giacomoradin/SmartVase/docs/SmartVase_data_structure.md

# SmartVase Data Structure and Architecture

This document outlines the communication pathways, MQTT topics, and Firestore paths used in the SmartVase system. 

### Architectural Overview
The system employs a hybrid communication model to optimize for hardware capabilities:
1. **ESP32-HUB (Telemetry & Control):** Communicates exclusively via lightweight MQTT. An Oracle Linux server running `mqtt_firestore_bridge.py` acts as a secure bi-directional bridge, translating MQTT payloads to/from Cloud Firestore.
2. **ESP32-CAM (Vision & Storage):** Communicates with Firebase Storage and Firestore, bypassing MQTT entirely.
3. **Flutter App:** Communicates exclusively with Firebase (real-time listeners for UI updates via Firestore, and loading images from Firebase Storage)

---

## 1. Telemetry Data

**Purpose:** Periodic sensor readings and device status sent from the ESP32 Hub.
**Direction:** ESP32 Hub -> MQTT Broker -> Oracle Server (`mqtt_firestore_bridge.py`) -> Firestore -> Flutter App
**MQTT Topic:** `smartvase/{hub_id}/telemetry`
**Firestore Path:** `smartvase/{hub_id}/telemetry/telemetry` *(Document ID: telemetry)*

**JSON Payload Example** (Hub v1.4.0 / proto v4.2; ambient fields such as
`temperature_c`, `humidity_percent`, `pressure_hpa` and `battery_voltage` are
included only when the corresponding sensor is fitted and returns a valid
reading; `time_valid` is false while the Mega runs on an unsynchronized software fallback
clock (RTC absent and no NTP sync received yet), meaning `timestamp_utc` defaults to
1970-01-01 08:00 and must not be used to date historical data):
{
  "timestamp_utc": 1678886400,
  "time_valid": true,
  "uptime_s": 12345,
  "device_id": "HUB_123456",
  "fw_version": "1.4.0",
  "movement_state": "IDLE",
  "lux": 540,
  "soil_moisture": 550,
  "water_level_cm": 14.5,
  "distances_cm": { "top": 87.2, "front_right": 120.5, "front_left": 95.1, "left": 44.0, "right": 61.3 },
  "free_ram_bytes": 2729,
  "counters": {
    "watchdog_resets": 0,
    "total_irrigations": 12,
    "total_irrigation_duration_s": 48,
    "total_motor_active_time_s": 310,
    "obstacles_avoided": 7,
    "stuck_events": 0,
    "bme_read_errors": 0,
    "log_overflows": 0,
    "pb_decode_failures": 0,
    "light_seeking_sessions": 5,
    "shadow_seeking_sessions": 2,
    "escape_attempts": 1
  },
  "care": {
    "enabled": true,
    "state": "BASK",
    "light_budget_pct": 62,
    "relocations_today": 2,
    "water_doses_today": 1,
    "growlight_min_today": 0
  }
}

The `care` object (proto v4.2, Mega v5.4.0+) carries the daily KPIs of the
autonomous care layer: `state` is one of `NIGHT | SEEK_SUN | BASK |
SEEK_SHADE | SHELTER | TOP_UP`, `light_budget_pct` is the percentage of the
plant profile's daily light target achieved so far (may exceed 100), and the
remaining fields are today's actuation counters. `enabled: false` means the
care layer is off and the values are static zeros.

### 1.1 LWT Status and Command Acknowledgment

**Purpose:** Connection status (Last Will and Testament) and command execution feedback.
**Direction:** ESP32 Hub -> MQTT Broker -> Oracle Server -> Firestore -> Flutter App
- **Status Topic:** `smartvase/{hub_id}/status` (retained `online` or `offline`)
- **Ack Topic:** `smartvase/{hub_id}/command/ack` (returns `status`, `value`, `cmd_id`, and `exec_time_ms`)

## 2. Log Events

**Purpose:** Event logs generated by the ESP32 Hub (e.g., errors, warnings, info).
**Direction:** ESP32 Hub -> MQTT Broker -> Oracle Server (`mqtt_firestore_bridge.py`) -> Firestore -> Flutter App
**MQTT Topic:** `smartvase/{hub_id}/logs`
**Firestore Path:** `smartvase/{hub_id}/logs/{auto_generated_id}` *(Collection: logs)*

**JSON Payload Example:**
{
  "timestamp_utc": 1678886500,
  "level": "ERROR", 
  "event": "WATER_LEVEL_LOW",
  "detail": "Water level below 5cm"
}

### 2.1 Autonomous-care events (Mega v5.4.0)

With the autonomous care layer enabled (`care on`, see
`docs/Plant_Care_Design.md`), the Mega emits the following events through the
normal log pipeline (same topic/path as above). They complement the `care`
object of the telemetry (§1): the telemetry carries the current KPI snapshot,
these logs carry the discrete events and the end-of-day summary:

| `event` | `level` | `detail` | Meaning |
|---|---|---|---|
| `care_day_end` | INFO | `b<pct> d<n> r<n> g<min>` | Daily KPI summary at day rollover: light-budget % achieved, water doses, relocations, UVA top-up minutes. Example: `b82 d2 r3 g15` |
| `care_state` | INFO | `SEEK_SUN` / `BASK` / `SEEK_SHADE` / `SHELTER` / `TOP_UP` / `NIGHT` | Care state transition |
| `care_water` | INFO | `dose` / `cycle_done` | One irrigation dose delivered / dose-soak-verify cycle completed (wet target reached) |
| `care_water` | WARN | `tank_empty` / `dose_cap` | Dose skipped: empty tank (refill needed) / daily dose cap hit (possible soil-probe fault) |
| `care_paused` | INFO | `manual_override` | A manual `setMode` (app/CLI) suspended autonomy for 30 minutes |
| `care_resumed` | INFO | `override_expired` | Autonomy resumed after the override grace period |

The app can parse `care_day_end` to render the daily "plant wellness"
summary (budget ring + doses + relocations) without any schema change.

## 3. Configuration Command

**Purpose:** Settings sent from the Flutter App to configure the ESP32 Hub's behavior (sensor thresholds). 
**Direction:** Flutter App -> Firestore -> Oracle Server (`mqtt_firestore_bridge.py` Listener) -> MQTT Broker -> ESP32 Hub
**Firestore Path:** `smartvase/{hub_id}/command/config`
**MQTT Topic:** `smartvase/{hub_id}/command/config`

**JSON Payload Example:**
{
  "soil_dry_threshold": 450,
  "light_threshold": 400
}

## 4 Action Commands

**Purpose:** Commands sent from the Flutter App to trigger specific physical actions or request diagnostics on the SmartVase.
**Direction:** Flutter App -> Firestore -> Oracle Server (`mqtt_firestore_bridge.py` Listener) -> MQTT Broker -> ESP32 Hub -> Arduino Mega
**Firestore Path:** `smartvase/{hub_id}/command/{action}`
**MQTT Topic:** `smartvase/{hub_id}/command/{action}`

Supported actions:
- **Water (Start Irrigation):**
  - Path: `smartvase/{hub_id}/command/water`
  - JSON: `{"cmd_id": 101, "type": "water", "duration_ms": 5000}`
- **Set Mode:**
  - Path: `smartvase/{hub_id}/command/setMode`
  - JSON: `{"cmd_id": 102, "type": "setMode", "mode": "LIGHT"}` *(mode can be "LIGHT", "SHADOW", or "IDLE")*
- **Emergency Stop:**
  - Path: `smartvase/{hub_id}/command/stop`
  - JSON: `{"cmd_id": 103, "type": "stop"}`
- **Request Diagnostics:**
  - Path: `smartvase/{hub_id}/command/requestDiagnostics`
  - JSON: `{"cmd_id": 104, "type": "requestDiagnostics"}`
- **Set Motion/Turn Parameters:**
  - Path: `smartvase/{hub_id}/command/setMotionParams`
  - JSON: `{"cmd_id": 105, "type": "setMotionParams", "reverse_ms": 1000, "turn_ms": 1200}`
- **Read Soil Humidity:**
  - Path: `smartvase/{hub_id}/command/readSoil`
  - JSON: `{"cmd_id": 106, "type": "readSoil"}`
- **Soft Reset Arduino Mega:**
  - Path: `smartvase/{hub_id}/command/softReset`
  - JSON: `{"cmd_id": 107, "type": "softReset"}`

## 5. Image Ready Notification (Edge Computed)

**Purpose:** This gets updated when a new image has been uploaded to Firebase Cloud Storage AND the leaf health analysis has been completed (by the lightweight vision algorithm on the edge).
**Direction:** ESP32-CAM -> Firebase (Storage & Firestore) -> Flutter App
*Note: This data path bypasses MQTT entirely.*
**Firestore Path:** `smartvase/{cam_id}/vision/latest`

**JSON Payload Example:**
{
  "timestamp_utc": 1678886405,
  "image_url": "gs://smartvase-7cfd9.firebasestorage.app/images/CAM_123456_1678886405.jpg",
  "resolution": "800x600",
  "size_bytes": 397847,
  "crc32": 1239082,
  "capture_time_ms": 254,
  "plant_healthy": true,
  "status_message": "Healthy: Basil plant has good turgor and green foliage!",
  "foliage_coverage": "45.2%",
  "green_ratio": "85.1%",
  "brown_ratio": "4.3%"
}

## Notes
For the device ids are hardcoded:
- hub_id = HUB_123456
- cam_id = CAM_123456
