giacomoradin/SmartVase/docs/assets/SmartVaseProjectPresentation.pdf

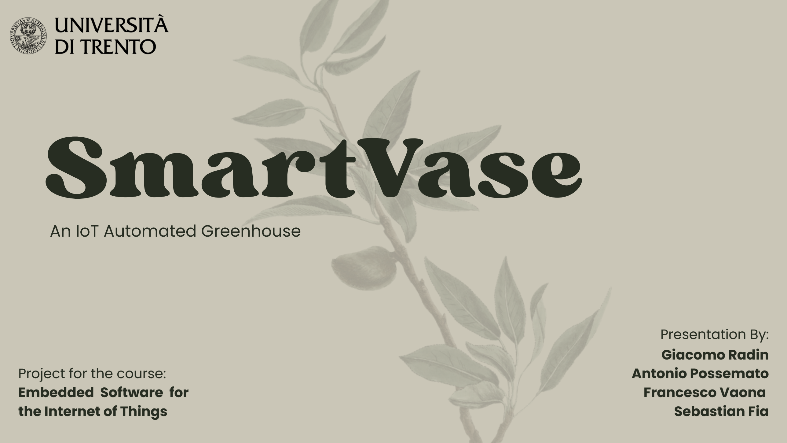
[picture p3: page 1]

# SmartVase

Presentation By:
Giacomo Radin
Antonio Possemato
Francesco Vaona
Sebastian Fia

Project for the course:
Embedded Software for
the Internet of Things

## An IoT Automated Greenhouse

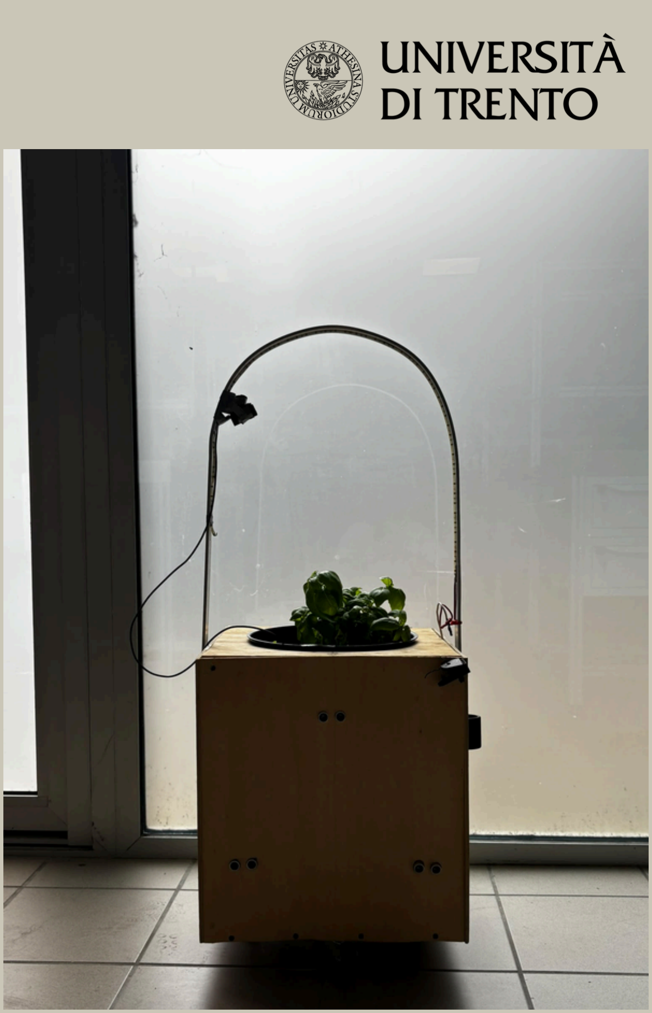
[picture p4: figure]

# Project Outline

A plant in a normal vase cannot survive without continuous human care. To solve this we created Smartvase: an IoT vase that makes plants grow reliably and autonomously.

Features:
Light detection, movement towards light, UV lighting Ultrasensors for Movement
Humidity detection, automatic irrigation
Periodic image capture and leaf health analysis on edge Mobile app to monitor and control the system

Main Hardware components
Arduino Mega: direct hardware control of sensors and actuators ESP32 Standard(HUB): communication hub of the system ESP32-CAM: image capture and edge analysis

Project members contributions
We mainly worked togther in the fablab from the same pc At the end we divided the sections to finish the project

# Internal Communication and

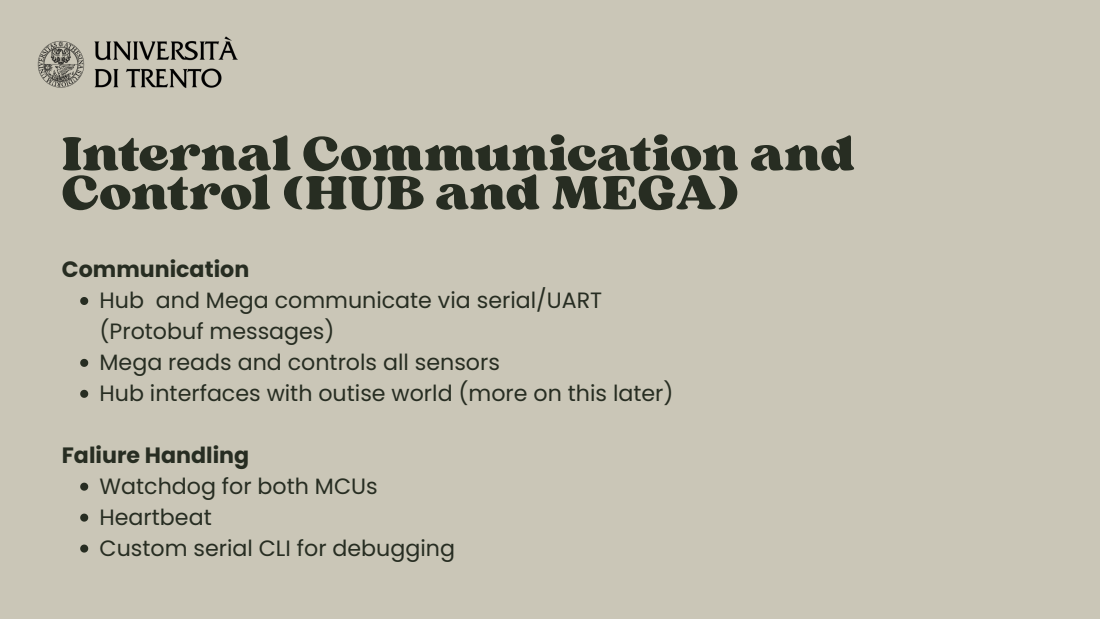
[picture p5: page 3]

Control (HUB and MEGA)

Communication
Hub and Mega communicate via serial/UART
(Protobuf messages)
Mega reads and controls all sensors
Hub interfaces with outise world (more on this later)

Faliure Handling
Watchdog for both MCUs
Heartbeat
Custom serial CLI for debugging

# Core Algorithms and Logic

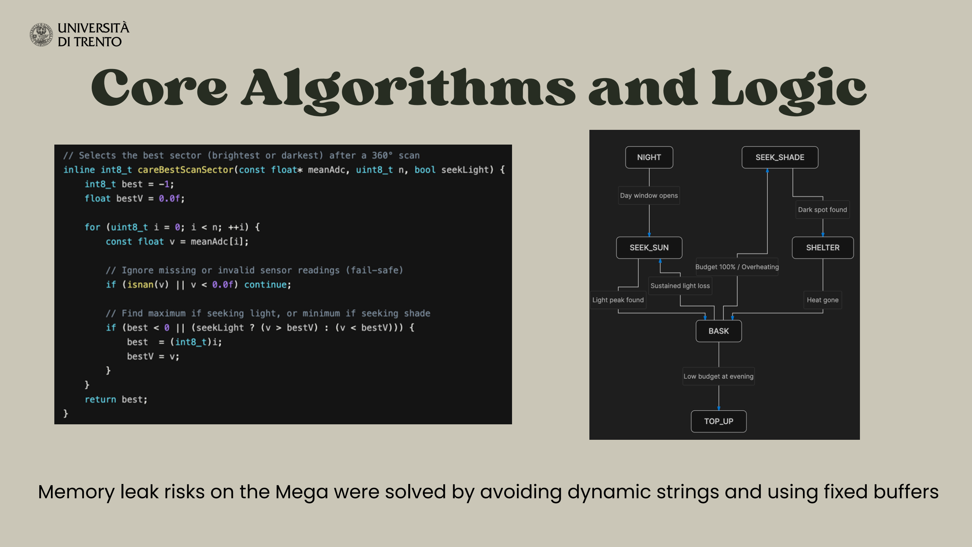
[picture p6: page 4]

Memory leak risks on the Mega were solved by avoiding dynamic strings and using fixed buffers

# External Communication

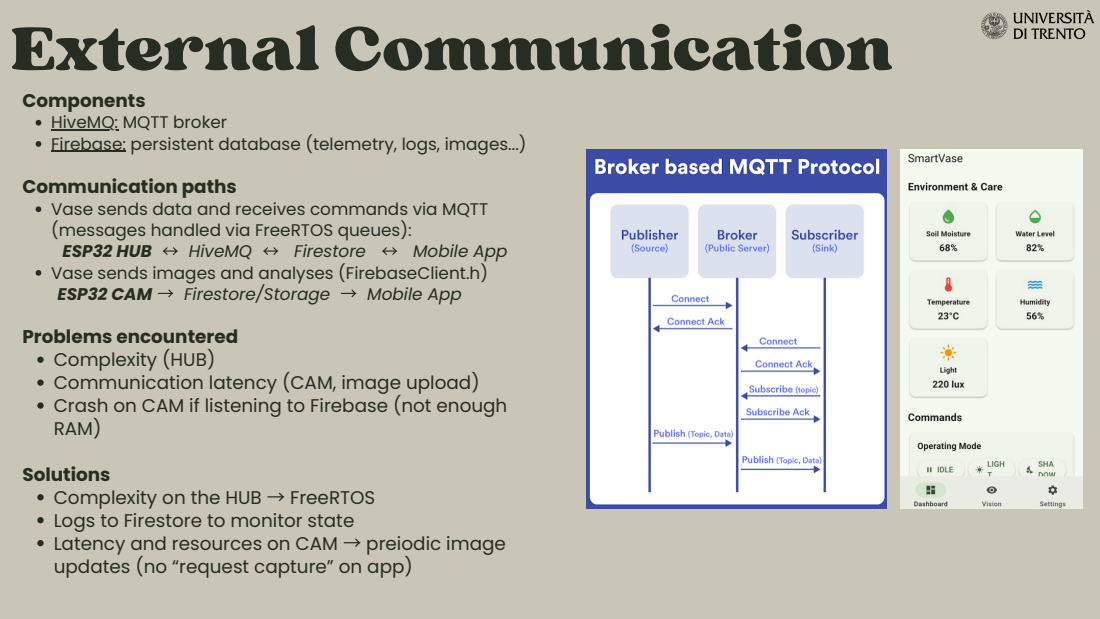
[picture p7: page 5]
ESP32 HUB ↔; HiveMQ ↔; Firestore ↔; Mobile App; ESP32 CAM →; Firestore/Storage →

Components
HiveMQ: MQTT broker
Firebase: persistent database (telemetry, logs, images...)
Communication paths
Vase sends data and receives commands via MQTT
(messages handled via FreeRTOS queues):
Vase sends images and analyses (FirebaseClient.h)
Problems encountered
Complexity (HUB)
Communication latency (CAM, image upload)
Crash on CAM if listening to Firebase (not enough
RAM)
Solutions
Complexity on the HUB → FreeRTOS
Logs to Firestore to monitor state
Latency and resources on CAM → preiodic image
updates (no “request capture” on app)

### On-Device Edge Vision: Configures the OV2640 sensor via I2C (SCCB)

# On-Edge Vision & Diagnostics

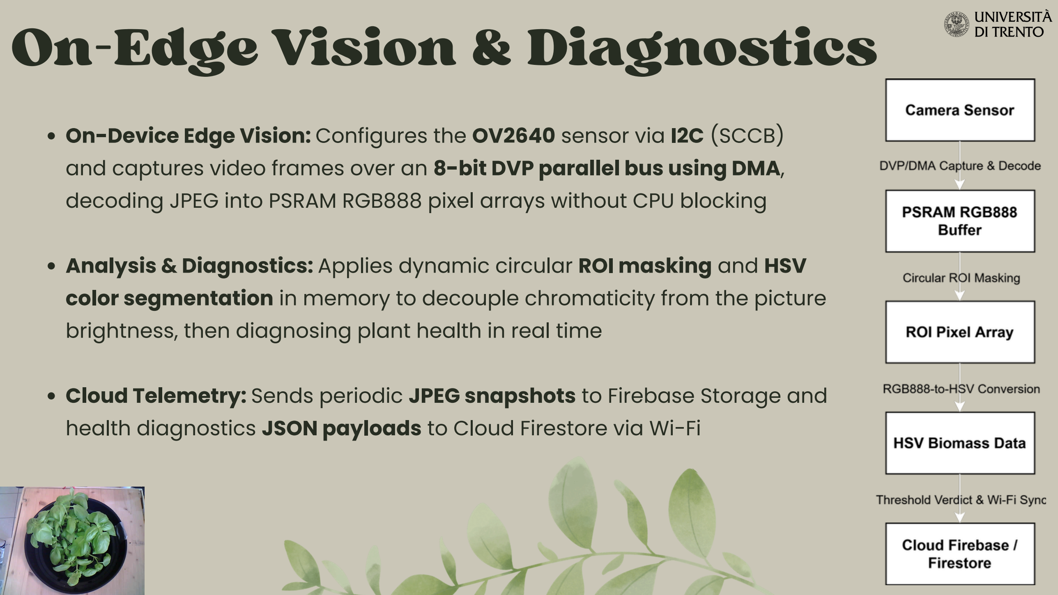
[picture p8: page 6]

and captures video frames over an 8-bit DVP parallel bus using DMA,

### decoding JPEG into PSRAM RGB888 pixel arrays without CPU blocking

### Analysis & Diagnostics: Applies dynamic circular ROI masking and HSV color segmentation in memory to decouple chromaticity from the picture brightness, then diagnosing plant health in real time

### Cloud Telemetry: Sends periodic JPEG snapshots to Firebase Storage and health diagnostics JSON payloads to Cloud Firestore via Wi-Fi

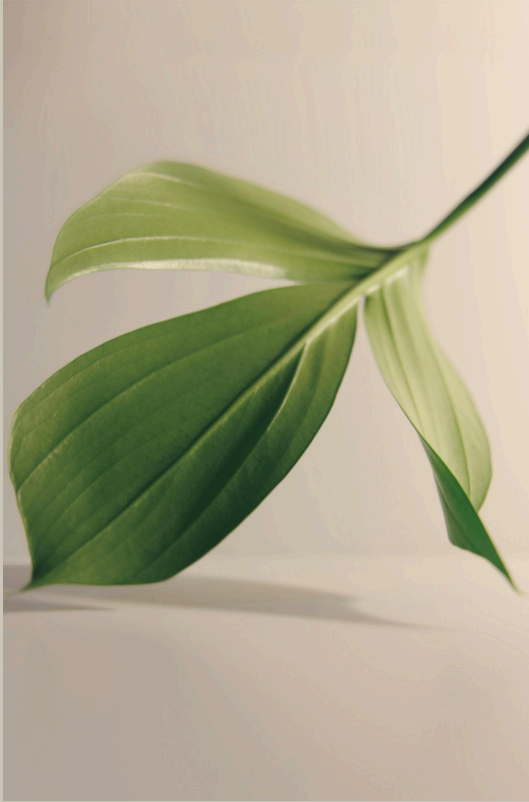
[picture p9: figure]

# Future Work

## ML system for vision, create labeled dataset taking pictures with CAM Request image capture on CAM via MQTT Additional app features (e.g. control movement directly, images timelapse) Docking Station for battery recharge and water refill

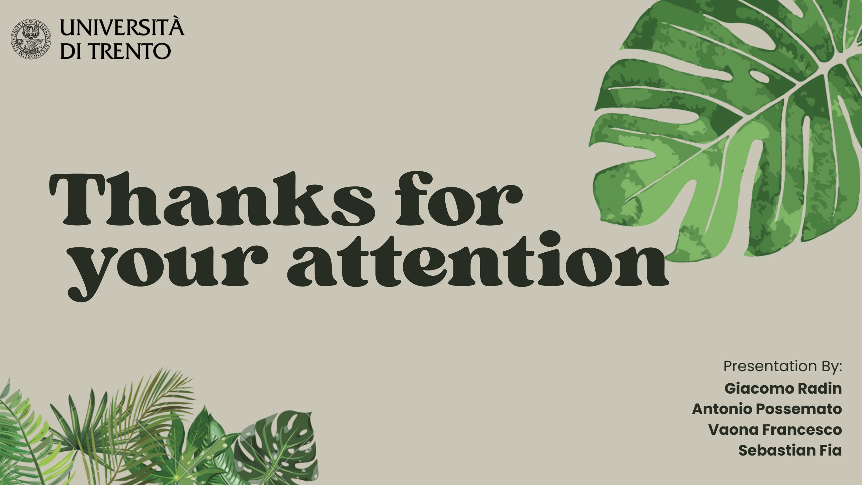
[picture p10: page 8]

# Thanks for your attention

Presentation By:
Giacomo Radin
Antonio Possemato
Vaona Francesco
Sebastian Fia
