giacomoradin/SmartVase/docs/assets/smartvase_photo.jpeg

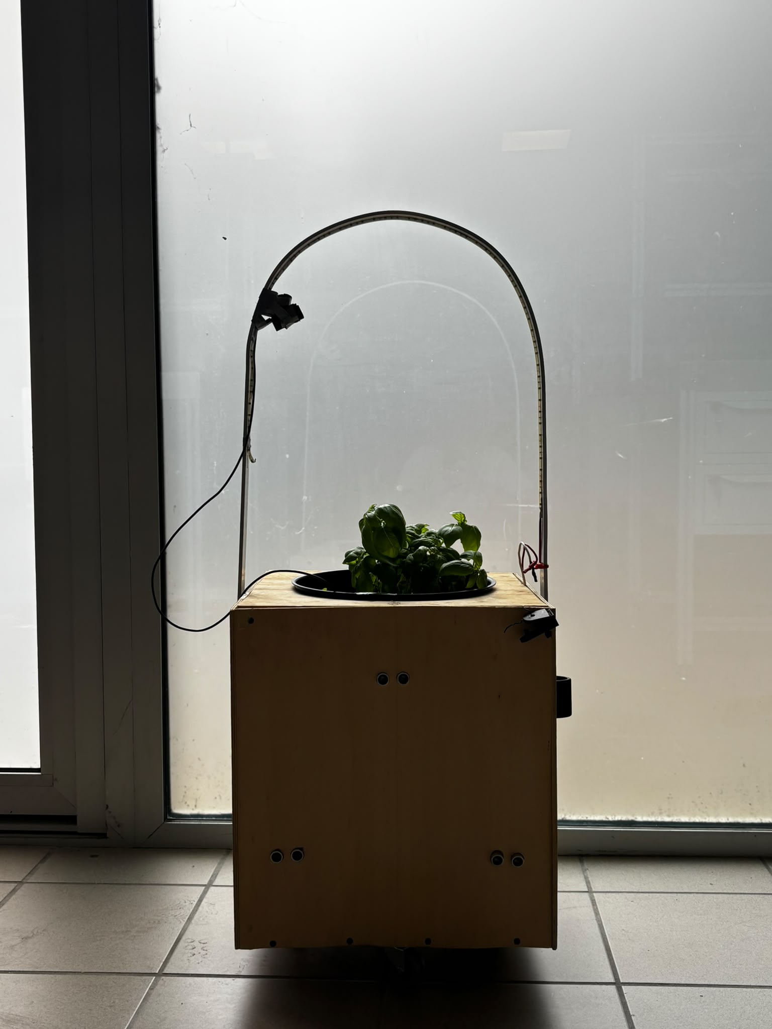
docs/assets/smartvase_photo.jpeg
