giacomoradin/SmartVase/vision/data/diseased/plant_d1.jpg

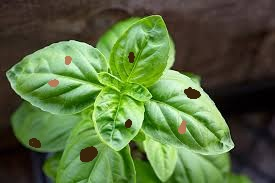
vision/data/diseased/plant_d1.jpg
