giacomoradin/SmartVase/docs/Hardware_Verification_Sheet.md

# SmartVase: Hardware verification sheet and sensor documentation

> **How to use this document**: bring it to the lab (printed or on the
> laptop) and **fill in the `-> ____` fields** with the prototype at hand.
> It is split into three parts:
> 1. **Missing information**: what the firmware/documentation assumes
>    but that no one has ever verified on the real prototype.
> 2. **Component sheets**: how each sensor/actuator works, datasheet specs,
>    known pitfalls and what to check (online sources at the bottom of each
>    sheet).
> 3. **Practical test checklist**: tests with the expected outcome and a
>    field for the measured value.
>
> The **operational procedure** (order of steps, CLI commands, flashing) is in
> [`Lab_Bringup_Checklist.md`](Lab_Bringup_Checklist.md): the two documents are
> used together: that one says *how*, this one says *what to record*.

---

## 1. Missing information to collect with the prototype in hand

### 1.1 Power architecture ⚡ (the biggest gap)

Not documented anywhere. Without this picture it is impossible to
diagnose brownouts, spontaneous resets or unstable ADC readings.

| Question | Recorded |
|---|---|
| What powers the Mega? (USB / Vin / direct 5V) | -> ____ |
| What powers the ESP32 Hub? | -> ____ |
| What powers the ESP32-CAM? (needs a dedicated 5V >= 2A) | -> ____ |
| Motor power voltage (VIN of the VNH5019 shield, 5.5 to 24V) | -> ____ V |
| Where does the pump get its voltage from? (never from the Mega's 5V) | -> ____ |
| Is there a main battery? Chemistry/voltage/capacity | -> ____ |
| Are all grounds common (Mega<->shield<->battery)? (continuity) | -> YES / NO |
| Shield logic VDD: generated by the shield (VOUT/ARDVIN) or by the Mega? | -> ____ |
| Shield "EN A=B" jumper closed (ties ENA/ENB together per motor)? | -> YES / NO |

### 1.2 Module identification (photo + part number for each)

| Component | To identify | Recorded |
|---|---|---|
| Motor driver | **Pololu Dual VNH5019 Shield** (`ash02b`, 2014): confirmed | ✓ |
| DC motors | Model, rated voltage, gearbox, stall current if known | -> ____ |
| Relay module | 2 channels: ch1 (D10) = pump, ch2 (D11) = UVA lights (on the NC contact). Part number, JD-VCC jumper? | -> ____ |
| Pump | Model, voltage (typically 3 to 6V), current, flyback diode already on board? | -> ____ |
| Soil-moisture fork | Bare probes on a divider, or comparator module (LM393) with an AO output? | -> ____ |
| Photoresistor | Bare LDR (GL5528?) or KY-018 module? Fixed divider resistance? | -> ____ |
| RTC module | DS3231 or DS3232? CR2032 battery present and what voltage? | -> ____ |
| ESP32-CAM | Programmer available: 3.3V FTDI or MB base? | → ____ |
| Mega↔Hub UART | 5V→3.3V divider/level shifter already provided for in the wiring? | → YES / NO |
| BME680 | Final confirmation: absent from the prototype (firmware: flag set to 0) | → confirmed? |

### 1.3 Geometry and directions (needed for the firmware thresholds)

| Measurement | Recorded | Goes into |
|---|---|---|
| Tank internal depth (bottom→lid) | → ____ cm | `tank <cm>` |
| US4→water distance with the tank **full** | → ____ cm | calibration |
| US4→water distance with the tank **empty** | → ____ cm | `tank <cm>` (≈ empty − 2) |
| Fork: ADC in **air** / **water** / **damp soil** | → ____ / ____ / ____ | `soil_dry_threshold` |
| LDR: ADC **dark** / **ambient** / **flashlight** | → ____ / ____ / ____ | `light_threshold` |
| LDR: more light = **higher** or **lower** ADC? | → ____ | affects light/shadow-seek |
| Motors: `motor f` → both wheels forward? L/R correct? | → ____ | mapping in `Movement.cpp` |
| Motors: common GND Mega↔shield VNH5019 (continuity < 1 Ω)? | → YES / NO | cause #1 of 0V outputs |
| Pump relay (ch1/D10): de-energized at boot? | → YES / NO | `PUMP_RELAY_ACTIVE_LOW` |
| UVA lights (ch2/D11): wired on which contact, NO or **NC**? | → ____ | the firmware assumes **NC** (rest=on) |
| Height of the navigation probes above the floor | → ____ cm | obstacle thresholds |

---

## 2. Component sheets (documentation and pitfalls)

### 2.1 HC-SR04: ultrasonic distance sensor (×6)

**Principle**: a **10 µs** trigger pulse causes an **8-cycle burst at 40 kHz**
to be emitted; the ECHO pin stays high for a time proportional to the
round-trip travel of the sound. Distance ≈ `t_echo / 58` µs/cm.

**Key specs** (datasheet): 5V supply, ~15 mA draw, 2 to 400 cm range (optimal
10 to 250 cm), ~3 mm resolution, **~15° usable cone**, ~20 Hz maximum polling
rate (≥ 50 to 60 ms between readings of the same probe).

**Known pitfalls**:
- **Blind zone under 2 cm** and unstable readings under 4 cm.
- **Soft** surfaces (fabric, foliage) or **very tilted** ones absorb or
  deflect the echo → missing readings. The lab floor is the easy case; the
  pot with the plant is not.
- **Cross-talk**: two probes listening to the same echo fool each other.
  The firmware reads **one probe every 30 ms in round-robin**, so two
  consecutive readings are 30 ms apart and the same probe is re-read every
  180 ms: the constraints are respected by construction.
- On out-of-range some clones keep ECHO high for up to ~200 ms: the driver
  (`Ultrasonic.cpp`) uses a timeout and returns `NAN`, and the re-read
  happens well after the echo has died out.

**How the firmware handles it**: EMA filter (alpha=0.4), valid range 2 to 200 cm
(120 for US4), 10 consecutive invalid readings → `NAN` → for US4 this
triggers the pump fail-safe.

**To verify tomorrow**: see tests T2/T3. If a probe always reads `NAN`:
trig/echo are swapped (compare against `PINS - Sheet1.csv`) or VCC/GND is missing.

Sources: [SparkFun datasheet](https://cdn.sparkfun.com/datasheets/Sensors/Proximity/HCSR04.pdf) ·
[Handsontec user guide](https://www.handsontec.com/dataspecs/HC-SR04-Ultrasonic.pdf) ·
[Adafruit guide](https://cdn-learn.adafruit.com/downloads/pdf/ultrasonic-sonar-distance-sensors.pdf)

### 2.2 DS3232: I²C Real-Time Clock

**Principle**: RTC with a **temperature-compensated TCXO** oscillator:
**±2 ppm** accuracy (~ ±1 minute/year). I²C address **0x68**. The DS3232
adds SRAM compared to the DS3231; for us they are equivalent.

**Backup battery**: a **CR2032** keeps the time while the device is off
(backup draw ~3 uA -> 3 to 10 years of life).

**The flag we care about: OSF** (Oscillator Stop Flag, bit 7 of status
register 0x0F): it is 1 if the oscillator has stopped since the time was
last set -> **the time read is not reliable**. Typical of a new module or
one with a dead/absent battery. The firmware reads it (`rtc` in the CLI) and
`rtc set <epoch>` clears it by writing the time.

**To verify tomorrow**: is the battery present? `rtc` → `time_valid`; after
`rtc set`, **remove power for 30 s** and re-check that the time advances
(backup-battery test, T6).

Sources: [DS3231 datasheet (Analog Devices)](https://www.analog.com/media/en/technical-documentation/data-sheets/ds3231.pdf) ·
[module guide](https://easyelecmodule.com/ultimate-ds3231-rtc-module/)

### 2.3 Fork: resistive soil-moisture sensor

**Principle**: two probes measure the soil's **conductivity**: more
water -> lower resistance -> (on YL-69/FC-28-type modules with an analog
output) **lower AO voltage** -> lower ADC value. Typical values: dry/air
close to **1023**, submerged in water **~200 to 400**.

Note: **Watch the direction**: this holds for the standard topology of
commercial modules. If our fork is wired on a "home-made" divider the
direction might be inverted -> **must be measured, not assumed** (T4).
The firmware default `soil_dry_threshold = 450` assumes "dry = low value"
and is probably **to be inverted or re-calibrated** after the test.

**Known pitfall: electrolysis corrosion**: with the probes continuously
powered, the metal corrodes (visible degradation in 6 to 12 months). The
firmware currently reads the ADC continuously with the fork always
powered at 5V: **future TODO**: power the fork from a GPIO and turn it on
only for the reading (a few ms every minute), extending the sensor's life
by years.

**To verify tomorrow**: T4 (three values: air / water / damp soil) and
write down the direction. Also check whether there is an LM393 comparator
module in between (in that case use the **AO** output, not DO).

Sources: [Random Nerd Tutorials YL-69](https://randomnerdtutorials.com/guide-for-soil-moisture-sensor-yl-69-or-hl-69-with-the-arduino/) ·
[YL-69 datasheet](https://www.electronicoscaldas.com/datasheet/YL-69-HL-69.pdf) ·
[FC-28 guide](https://maker.pro/arduino/projects/arduino-soil-moisture-sensor)

### 2.4 Photoresistor (LDR, presumed GL5528)

**Principle**: resistance that drops with light. GL5528: **8 to 20 kΩ at 10 lux**,
**> 1 MΩ in the dark**. It is read with a divider (typically a fixed 10 kΩ).

**Signal direction** (to be determined, T5):
- LDR towards **VCC** (fixed resistor towards GND): more light → **higher**
  ADC (more common topology, gives ~1.6 to 2.5 V indoors).
- LDR towards **GND**: more light → **lower** ADC.

The firmware default `light_threshold = 600` and the light/shadow-seek
logic (`Movement.cpp`: turns right if `lux < threshold` in LIGHT mode)
assume "more light = higher value". **If the divider is inverted, the
robot will seek darkness while believing it is seeking light**: this is
why T5 is mandatory before trying `mode light`.

Sources: [GL5528 specs](https://www.devobox.com/en/photosensors/9-photoresistor-gl5528-ldr.html) ·
[LDR divider guide](https://blog.udemy.com/arduino-ldr/)

### 2.5 Motor driver (Pololu Dual VNH5019 Motor Driver Shield `ash02b`, 2014)

**Confirmed** (no longer L298N): a dual shield with two **VNH5019** chips,
5.5 to 24 V, ~12 A continuous per channel. Note: Interface **different from the L298N**.

**Principle**: 4 signals per motor: `INA`/`INB` (direction), `PWM`
(speed), `EN/DIAG` (enable + fault flag). Truth table: `INA=1,
INB=0, PWM=high, EN=1` → forward; `INA=0, INB=1` → backward; `INA=INB` → brake.
`EN/DIAG` is open-drain with a pull-up on the shield (R1/R10 4.7k → VDD): at
rest HIGH = driver **enabled**; the chip pulls it LOW on a fault (overtemp/
overcurrent/undervoltage).

**Specs and pitfalls**:
- **Common GND Mega↔shield mandatory**: without a ground reference the
  logic signals have no return path → outputs at 0V even with VDD present.
  This is cause #1 of "the code runs but the motors don't move".
- **Logic VDD** ~5 V: the shield can generate it from its own regulator
  (VOUT, "ARDVIN=VOUT" jumper); in that case **do not** also connect the
  Mega's 5V.
- **EN A=B**: the shield has a jumper to tie the chip's ENA/ENB together
  into a single EN line per motor: check it is closed.
- Pins in our wiring (CSV): M1PWM=D6, M1INA=D43, M1INB=D45, M1EN=D41
  (left); M2PWM=D7, M2INA=D47, M2INB=D49, M2EN=D39 (right). Note: On the
  standard shield pin 6 is M1EN, not M1PWM: make sure the wire from D6
  really goes to **M1PWM**. Which channel is the left wheel → verify on the bench (T7).
- The firmware (`Movement.cpp`) reads EN/DIAG as `INPUT_PULLUP`: `diag` shows
  `fault L/R`. EN is optional (wiring it is only needed for fault diagnostics).

Sources: [Pololu Dual VNH5019 Shield](https://www.pololu.com/product/2507) ·
[VNH5019 datasheet](https://www.pololu.com/file/0J504/vnh5019.pdf) ·
[Pololu user's guide / library](https://www.pololu.com/docs/0J49)

### 2.6 5V relay module (pump)

**Principle**: the GPIO drives (usually via an optocoupler) the coil of
an electromechanical relay (typically Songle **SRD-05VDC-SL-C**, contacts
rated up to 10 A / 30 V DC). The load goes on the **COM + NO** (normally
open) contacts: relay at rest = pump off.

**Pitfalls**:
- **Trigger polarity**: optocoupler-based modules are almost always
  **active LOW** (GPIO LOW = relay ON), simple-transistor ones are often
  active high. The firmware assumes active-low (`PUMP_RELAY_ACTIVE_LOW 1`
  in `Pump.cpp`): test T8 confirms or disproves this in 10 seconds.
- **JD-VCC jumper**: if present and removed, the coil must be powered
  separately (galvanic isolation). With the jumper in place, the coil and
  logic share the 5V: fine for us, but the coil draws ~70 mA: also count
  this in the 5V budget.
- The relay coil already has its own diode on the module, but the **pump**
  (a DC motor) generates back-EMF spikes on the contacts: if there is no
  **flyback diode (e.g. 1N4007) in antiparallel across the pump**, add one
  (cathode to +).

Sources: [Circuit Basics relay](https://www.circuitbasics.com/setting-up-a-5v-relay-on-the-arduino/) ·
[SRD-05VDC datasheet](https://www.datasheetcafe.com/srd-05vdc-sl-c-datasheet-pdf/) ·
[JD-VCC explained](https://www.geya.net/5v-relay-module-how-it-works-and-application/)

### 2.7 Mini submersible pump (presumed 3 to 6V DC)

**Typical specs**: 3 to 6 V, 100 to 200 mA, ~40 to 110 cm head. Must never be
driven directly from a GPIO (~40 mA limit): in our design it goes through the relay.

**Pitfalls**:
- **Dry running**: small submersible pumps use the water to cool and
  lubricate themselves: running dry damages them quickly. This is exactly
  the reason for the **tank protection** implemented in the firmware
  (blocking on `tank_empty_cm` + auto-stop): test T9 validates it end-to-end.
- **Flyback diode** across the pump if missing (see 2.6).
- Priming: on first power-up it may take a few seconds for the water to
  fill the impeller → do the first test with `pump 5000`.

Sources: [mini pump guide](https://zbotic.in/mini-water-pump-guide-dc-submersible-peristaltic-pumps-for-arduino/) ·
[controlling a pump with a relay](https://www.hibit.dev/posts/128/how-to-control-mini-water-pump-with-arduino)

### 2.8 ESP32-CAM (AI-Thinker, OV2640)

**Power: cause #1 of the problems**: it needs **5V with at least
500 mA real**(2A recommended); with Wi-Fi + camera the current spikes
cause **brownouts** (spontaneous resets) if the power supply is weak
(e.g. taken from the FTDI). Remedy: dedicated 5V supply + **≥ 470 µF
electrolytic capacitor between 5V and GND** near the board. The firmware
disables the brownout detector at boot, but that is a band-aid: if T11
shows resets, it is the power supply.

**Flashing the firmware**: without an MB base you need a 3.3V FTDI and
**GPIO0 tied to GND during reset** to enter the bootloader; then
disconnect GPIO0 and reset again. GPIO4 drives the onboard flash LED
(not used by the firmware today).

**Camera**: the OV2640's flat cable is cause #1 of `Camera init
FAILED`: reseat it gently.

Sources: [Random Nerd Tutorials pinout](https://randomnerdtutorials.com/esp32-cam-ai-thinker-pinout/) ·
[brownout fix](https://www.makerguides.com/fix-brownout-of-esp32-cam/) ·
[DroneBot dev guide](https://dronebotworkshop.com/esp32-cam-develop/)

---

## 3. Practical test checklist (robot wired up)

> Prerequisite: firmwares flashed (v5.4.0 / v1.4.0 / v2.2.0), serial monitor at
> 115200. On the Mega: **`standalone on`** as the first command.
> Detailed step-by-step procedure in `Lab_Bringup_Checklist.md`.

### T1: Power and grounds
- [ ] Multimeter: Mega's 5V under load → expected 4.75 to 5.25 V. Recorded → ____ V
- [ ] Motor voltage at the H-bridge input → ____ V (fill in §1.1)
- [ ] Ground continuity between Mega, H-bridge, relay, sensors → expected < 1 Ω everywhere
- [ ] No spontaneous Mega reset over 5 minutes of repeated `status`

### T2: Navigation ultrasonic sensors (US1, US2, US3, US5, US6)
For each probe, using a rigid target (book/cardboard) and a tape measure,
read `sensors`:
- [ ] at **10 cm** → recorded: US1 ____ US2 ____ US3 ____ US5 ____ US6 ____
- [ ] at **50 cm** → recorded: US1 ____ US2 ____ US3 ____ US5 ____ US6 ____
- [ ] at **100 cm** → recorded: US1 ____ US2 ____ US3 ____ US5 ____ US6 ____
- Expected outcome: error < ±2 cm up to 1 m. Hand in front of the probe → the
  value drops within ~1 s (EMA settling).

### T3: US4 / tank
- [ ] Full tank → `tank`: recorded ____ cm
- [ ] Empty tank → `tank`: recorded ____ cm
- [ ] Threshold set: `tank ____` (≈ empty − 2) and verify with `config`

### T4: Soil-moisture fork (write down the DIRECTION)
- [ ] In **air** → `sensors`: soil = ____
- [ ] In **water** → soil = ____
- [ ] In **damp soil** → soil = ____
- Direction: is wet = **higher / lower** value? → ____
  (if "wet = lower" the default `soil_dry_threshold=450` needs rethinking)

### T5: Photoresistor (BEFORE trying mode light/shadow)
- [ ] LDR **covered** → lux = ____
- [ ] **Ambient** light → lux = ____
- [ ] **Flashlight** on it → lux = ____
- Direction: is more light = **higher / lower** value? → ____
  (the firmware assumes "higher"; if inverted, light-seek and shadow-seek
  end up swapped)

### T6: RTC
> CR2032 battery **replaced on 2026-07-01** (the previous one was dead: the
> chip fell back to the software clock). This test verifies the replacement.
> Module: **HW-084** (DS3231 + AT24C32 EEPROM on the same board). Note: Its
> charging circuit is meant for rechargeable LIR2032 cells: with a
> non-rechargeable CR2032, remove the ~200 Ω charging resistor (or diode).
- [ ] `i2cscan` (CLI) → expected **0x68** (RTC) **and** **0x57** (module EEPROM).
      Both missing = wiring/power (check the mapping SDA→20 / SCL→21, not just
      wire continuity); only 0x57 = bus fine but DS3231 silent (module fault).
- [ ] `rtc` → rtc_ok = YES; time_valid = ____; fake_clock must be **NO**
- [ ] `rtc set <epoch>` (epoch from PowerShell: `[DateTimeOffset]::Now.ToUnixTimeSeconds()`)
- [ ] Power off the Mega for 30 s, power back on → `rtc`: has the time advanced? → YES / NO
      (NO = dead/absent CR2032 battery)
- [ ] A reliable time matters more from v5.4.0 on: the autonomous care layer
      (`care on`) anchors its whole day to the clock (see §1.9 of the
      bring-up checklist).

### T7: VNH5019 motors (wheels lifted, then on the ground)
- [ ] Common GND Mega↔shield verified (continuity < 1 Ω)? → ____ (cause #1 of 0V outputs)
- [ ] `diag` → the `fault L/R` line = `ok/ok`? → ____ (if `!!FAULT`: VNH5019 protection)
- [ ] `motor f 60000` → both forward? → ____ (if one is inverted: the motor's wires or INA/INB)
- [ ] `motortest` → are `motor l` / `motor r` consistent with the physical left/right? → ____
      (if swapped: swap the LEFT/RIGHT groups in `Movement.cpp`)
- [ ] Motor terminal voltage with `calib 255 255` during `motor f` → ____ V
      (VNH5019: low drop ~0.2 to 0.3 V at moderate load, much less than an L298N)
- [ ] On the ground, 2 m of straight driving with `mode light` in a uniform
      environment, or `motor f 3000`: lateral drift → ____ cm → correct with `calib`

### T8: Relay (pump DISCONNECTED)
- [ ] The relay does NOT click at power-on → YES / NO
      (NO = active-high module → `PUMP_RELAY_ACTIVE_LOW 0` and reflash)
- [ ] With US4 on a target < threshold: `pump 1000` → click ON and click OFF after 1 s
- [ ] Multimeter on COM/NO: contact closed only during the command

### T9: Pump + tank protection (the v5.4.0 requested test)
- [ ] Empty tank: `pump 2000` → expected `BLOCKED: tank empty` → OK? ____
- [ ] US4 disconnected (or covered): `pump 2000` → expected `tank_sensor_fault` → ____
- [ ] Full tank: `pump 5000` → the pump runs and water flows → ____
- [ ] Flow rate: ml collected in 10 s of `pump 10000` → ____ ml
      (needed to size future automatic `water` commands)
- [ ] **Auto-stop**: `pump 30000` and lift US4/empty the tank → the pump
      stops by itself with a `pump_stop` log → OK? ____

### T10: Hub ↔ Mega chain (with a divider on the Mega's TX!)
- [ ] Hub `status` → mega_link OK within 10 s of connecting
- [ ] Hub `telemetry` → distances consistent with `sensors` on the Mega
- [ ] Hub `soil` → `[ACK Mega] ... value=` equal to T4
- [ ] Hub `water 2000` with a full tank → ACK OK + pump active
- [ ] Hub `water 2000` with an empty tank → ACK `ERROR tank_empty`
- [ ] Mega `standalone off` → no degraded mode with the Hub connected (30 s heartbeat)
- [ ] Hub off for 2+ min → Mega in degraded mode `hub_missing`; powered back on → recovery

### T11: ESP32-CAM
- [ ] `status` → camera = OK; free_heap → ____ B
- [ ] `capture` ×5 → 5 ok frames, sizes ____ ÷ ____ bytes, time ____ ms
- [ ] No reset/brownout during the captures → OK? ____
      (if it resets: power supply, see sheet 2.8)

### T12: Final stress test (if time remains)
- [ ] Mega: 10 minutes in `mode light` in an area with obstacles: the robot
      avoids them, never enters STUCK permanently, `stats` at the end of the
      run → record obstacles_avoided ____ , stuck_events ____ , watchdog_resets ____
      (expected 0)
- [ ] `status` at the end of the stress test: freeRam → ____ B (expected stable ≳ 3500)

---

## 4. At the end of the day

Report the values collected here and in `SmartVase_Project_State.md`, and
if firmware changes are needed (relay polarity, LDR/fork direction, motor
swap) commit them right away with the measured values in the commit
message: in a week these numbers will be the only reliable memory.
