giacomoradin/SmartVase/vision/debug_brown_plant_d1.jpg

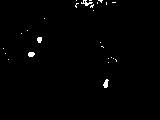
vision/debug_brown_plant_d1.jpg
