giacomoradin/SmartVase/vision/debug_brown_plant_h1.jpg

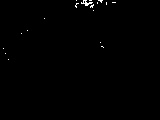
vision/debug_brown_plant_h1.jpg
