giacomoradin/SmartVase/vision/debug_green_plant_d1.jpg

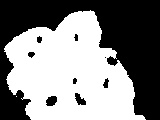
vision/debug_green_plant_d1.jpg
