giacomoradin/SmartVase/vision/debug_green_plant_h1.jpg

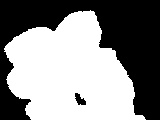
vision/debug_green_plant_h1.jpg
