giacomoradin/SmartVase/firmware/1_esp32-hub/Radin_Giacomo_SmartVase_LogicWebHub_ESP32Standard/include/smartvase_aliases.h

/*! @file smartvase_aliases.h
 *  @ingroup HubMisc
 *  @brief Aliases without the `smartvase_` prefix for the types/tags generated
 *  by nanopb from `smartvase.proto`, so that the rest of the Hub code can use
 *  short names (e.g. `Command` instead of `smartvase_Command`).
 *  @details Schema v4.0 — 2026-05-19. Protobuf aliases only: no Mega-internal
 *  C++ types (DeviceConfig, CumulativeStats, etc.), which stay private to the
 *  Mega firmware.
 *  @note Must be kept aligned by hand with the canonical `.proto`
 *  (`infra/smartvase-proto/smartvase.proto`): if fields or tags are added or
 *  renamed in the `.proto`, update the corresponding aliases here after
 *  regenerating the `.pb.{c,h}` (see `infra/smartvase-proto/README.txt`
 *  for the complete schema-first workflow).
 *  @author Giacomo Radin
 *  @date 2025-10-20
 */

/*! @defgroup HubMisc Miscellaneous (protobuf aliases, certificates)
 *  @brief Cross-cutting support files: aliases for the generated protobuf
 *  types and the CA certificate for the TLS link to HiveMQ Cloud.
 */

#ifndef SMARTVASE_ALIASES_H_INCLUDED
#define SMARTVASE_ALIASES_H_INCLUDED

#include "smartvase.pb.h"

/*! @addtogroup HubMisc
 *  @{
 */

// --- Aliases for Types (Structs & Enums) ---
typedef smartvase_WrapperMessage         WrapperMessage;
typedef smartvase_Log_LogLevel           Log_LogLevel;
typedef smartvase_Command                Command;
typedef smartvase_CommandResponse_Status CommandResponse_Status;
typedef smartvase_MovementState          MovementState;
typedef smartvase_SetModeCommand_Mode    SetModeCommand_Mode;
typedef smartvase_TelemetryFast          TelemetryFast;
typedef smartvase_TelemetryDeep          TelemetryDeep;
typedef smartvase_Log                    Log;
typedef smartvase_Heartbeat              Heartbeat;
typedef smartvase_CommandResponse        CommandResponse;

// --- Message Descriptors ---
#define WrapperMessage_fields smartvase_WrapperMessage_fields

// --- Initialization Macros ---
#define WrapperMessage_init_zero    smartvase_WrapperMessage_init_zero
#define Log_init_zero               smartvase_Log_init_zero
#define Command_init_zero           smartvase_Command_init_zero
#define CommandResponse_init_zero   smartvase_CommandResponse_init_zero
#define TelemetryFast_init_zero     smartvase_TelemetryFast_init_zero
#define TelemetryDeep_init_zero     smartvase_TelemetryDeep_init_zero
#define Heartbeat_init_zero         smartvase_Heartbeat_init_zero

// --- 'oneof' Field Tags ---
#define WrapperMessage_telemetry_fast_tag   smartvase_WrapperMessage_telemetry_fast_tag
#define WrapperMessage_telemetry_deep_tag   smartvase_WrapperMessage_telemetry_deep_tag
#define WrapperMessage_log_tag              smartvase_WrapperMessage_log_tag
#define WrapperMessage_heartbeat_tag        smartvase_WrapperMessage_heartbeat_tag
#define WrapperMessage_command_tag          smartvase_WrapperMessage_command_tag
#define WrapperMessage_command_response_tag smartvase_WrapperMessage_command_response_tag

#define Command_water_tag                 smartvase_Command_water_tag
#define Command_set_mode_tag              smartvase_Command_set_mode_tag
#define Command_stop_tag                  smartvase_Command_stop_tag
#define Command_request_diagnostics_tag   smartvase_Command_request_diagnostics_tag
#define Command_set_motion_params_tag     smartvase_Command_set_motion_params_tag
#define Command_read_soil_tag             smartvase_Command_read_soil_tag
#define Command_soft_reset_tag            smartvase_Command_soft_reset_tag

// --- Enum Values ---
#define Log_LogLevel_INFO      smartvase_Log_LogLevel_INFO
#define Log_LogLevel_WARN      smartvase_Log_LogLevel_WARN
#define Log_LogLevel_ERROR     smartvase_Log_LogLevel_ERROR
#define Log_LogLevel_CRITICAL  smartvase_Log_LogLevel_CRITICAL

#define CommandResponse_Status_OK    smartvase_CommandResponse_Status_OK
#define CommandResponse_Status_ERROR smartvase_CommandResponse_Status_ERROR

#define SetModeCommand_Mode_IDLE   smartvase_SetModeCommand_Mode_IDLE
#define SetModeCommand_Mode_LIGHT  smartvase_SetModeCommand_Mode_LIGHT
#define SetModeCommand_Mode_SHADOW smartvase_SetModeCommand_Mode_SHADOW

#define MS_IDLE            smartvase_MovementState_M_IDLE
#define MS_MOVING          smartvase_MovementState_M_MOVING
#define MS_AVOID_START     smartvase_MovementState_M_AVOID_START
#define MS_AVOID_REVERSING smartvase_MovementState_M_AVOID_REVERSING
#define MS_AVOID_TURNING   smartvase_MovementState_M_AVOID_TURNING
#define MS_STUCK           smartvase_MovementState_M_STUCK

/*! @} */ // end of HubMisc group

#endif // SMARTVASE_ALIASES_H_INCLUDED
