giacomoradin/SmartVase/firmware/2_platform-controller_mega/Radin_Giacomo_SmartVase_PlatformController_ArduinoMega/src/Crc16.cpp

/*!
    @file   Crc16.cpp

    @ingroup MegaComm

    @brief  Implementation of CRC16-CCITT (see Crc16.h).

    @date   2026-05-20

    @author Giacomo Radin
*/

#include "Crc16.h"

uint16_t crc16_ccitt(const uint8_t* data, size_t length) {
    uint16_t crc = 0x0000;
    while (length--) {
        crc ^= (uint16_t)(*data++) << 8;
        for (uint8_t i = 0; i < 8; i++) {
            if (crc & 0x8000) crc = (crc << 1) ^ 0x1021;
            else              crc <<= 1;
        }
    }
    return crc;
}
