giacomoradin/SmartVase/(commit log)

2025-10-20 Add README for SmartVase Platform Controller firmware
    Added detailed README for SmartVase Arduino Mega firmware, outlining system architecture, key features, setup instructions, and future roadmap.
2025-11-04 feat: Implement telemetry data caching and publishing in ESP32-Hub\n\nThis commit addresses the TODOs in MainLogic.cpp and MainLogic.h by:\n- Adding _lastFastTelemetry and _lastDeepTelemetry member v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
    [MainLogic.cpp, MainLogic.h]
2025-11-04 refactor: Align communication architecture and firmware
    Standardize on JSON over MQTT for external communication and Protobuf over Serial for internal communication.
    Update README to reflect the new architecture.
    Align ESP32-Hub firmware to use specified JSON field names.
    Convert ESP32-CAM sketch to a full PlatformIO project.
    Fix build errors and add missing dependencies for both projects.
    Add build scripts for autonomous compilation.
    [MainLogic.cpp, main.cpp]
2026-05-19 Refactor completo firmware/vision/cloud per il nuovo prototipo
    Allineamento del firmware al nuovo PIN map (docs/PINS - Sheet1.csv) e
    implementazione dei moduli mancanti. La codebase precedente era stata
    scritta per un layout sensoriale diverso.
    Firmware Mega v5.0:
    - 6 HC-SR04 (US1=top, US2=front-right, US3=front-left, US4=water tank,
    US5=left, US6=right) con i pin del CSV
    - Modulo Pump dedicato per rele' pompa D10 (active-low, safety 60s)
    - RTC DS3232 (I2C 0x68) per timestamp epoch
    - Forcella umidita' suolo su A0, fotoresistore spostato su A1
    - Modulo Cli per debug su USB Serial (status/stats/config/sensors/...)
    - CRC16 estratto in utility condivisa (Crc16.h)
    - Hysteresis SRAM 800/1200 B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
2026-05-19 Update README: reflect v5 firmware refactor and current architecture
    - Architecture diagram updated to HiveMQ + Cloud Functions + Firestore
    - Mention 6 ultrasonic sensors, Pump module, FreeRTOS task layout
    - Add MQTT topic map summary (including command/ack)
    - Add Debug CLI section
    - Add Project Status section with current firmware versions
    - Cross-link docs/ARCHITECTURE.md for full reference
    - Vision pipeline section added (quality_gate + metrics + leaf_health)
2026-06-11 docs: add authoritative PIN map CSV and firmware project state document
    [PINS - Sheet1.csv]
2026-06-11 Mega v5.1: protezione pompa tanica-vuota, modalita' standalone, CLI estesa
    - Pompa bloccata se US4 oltre soglia tank_empty_cm (EEPROM, default 20cm,
    taratura da CLI) o lettura invalida; auto-stop durante l'irrigazione.
    - standalone on/off da CLI: sospende il deadman Hub per i test a banco.
    - Driver locali Ultrasonic (niente delay(50) per lettura, begin() corretto)
    e RtcDs3232 (build offline, niente dipendenza dal registry).
    - rtc set <epoch>, calib, tank, version in CLI; freeRam/pompa in status.
    - BME680 dietro flag (non montato): niente probe I2C ne' falsi
    bme_read_errors; batteria resta flag-off.
    - Reset del backoff anti-stuck dopo 60s di marcia pulita.
    - Init rele' senza glitch (liv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
    [Cli.cpp, Cli.h, Communication.cpp, Movement.cpp, Persistence.cpp, Pump.cpp, RtcDs3232.cpp, RtcDs3232.h]
2026-06-11 Hub v1.2: fix init code FreeRTOS, heartbeat verso Mega, CLI seriale
    - Fix crash latente: i manager globali copiavano gli handle delle code
    quando erano ancora NULL (static init); ora creati in setup() dopo
    xQueueCreate.
    - Heartbeat Hub->Mega ogni 30s: senza traffico periodico il deadman del
    Mega scattava anche con l'Hub collegato.
    - Nuova HubCli su USB: provisioning Wi-Fi/MQTT su NVS e comandi
    passthrough verso il Mega (water/mode/stop/soil/diag/telemetry) per
    testare la catena seriale senza rete; ack del Mega echeggiati a monitor.
    - WifiManager: timeout senza cancellare le credenziali ne' avviare l'AP;
    boot deterministico offline, autoreconnect attivo.
    - MqttManager: nessun tent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
    [HubCli.cpp, HubCli.h, MQTTManager.cpp, MQTTManager.h, MainLogic.cpp, MainLogic.h, WifiManager.cpp, main.cpp]
2026-06-11 CAM v2.1: fix compilazione e use-after-free, Wi-Fi non bloccante, CLI
    - Fix doppia dichiarazione di t0 in connectWifi: la v2.0 non compilava.
    - Fix use-after-free: fb->len letto dopo esp_camera_fb_return; i metadati
    del frame ora vengono copiati prima di restituire il buffer.
    - Riconnessione Wi-Fi non bloccante (retry 30s in background): prima il
    loop si congelava 30s a ogni tentativo, CLI inutilizzabile offline.
    - CLI seriale: provisioning NVS (set/save/show), capture di test senza
    upload, upload completo, stats, status; boot utilizzabile anche con
    camera guasta per diagnosi.
    - Cattura automatica solo con Wi-Fi connesso e upload_url configurato;
    upload_errors contati solo su tenta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
    [main.cpp]
2026-06-11 Build script con path pio portabile, checklist bring-up, stato progetto
    - build_*.bat: il path di pio.exe puntava a un profilo utente inesistente;
    ora %USERPROFILE% + %~dp0, con pass-through degli argomenti (-t upload).
    - docs/Lab_Bringup_Checklist.md: procedura di collaudo passo-passo per il
    laboratorio (ordine sicuro, taratura tanica, troubleshooting).
    - docs/SmartVase_Project_State.md e README Mega allineati a v5.1/v1.2/v2.1.
2026-06-11 docs: scheda di verifica hardware con schede sensori e test da compilare
    - Informazioni mancanti da raccogliere col prototipo (alimentazione,
    identificazione moduli, geometrie/direzioni per le soglie firmware).
    - Schede componenti documentate con fonti: HC-SR04, DS3232, forcella
    resistiva, LDR, L298N, modulo rele', pompa sommersa, ESP32-CAM.
    - Checklist T1-T12 di test pratici con esito atteso e campi da compilare
    (complementare alla Lab_Bringup_Checklist: quella e' la procedura,
    questa e' la raccolta dati).
2026-06-11 Fix CRC seriale Hub-Mega, persistenza EEPROM/NVS e captureNow CAM
    Secondo giro di verifica pre-bring-up, tre bug critici:
    - SerialManager (Hub): CRC-16 0xA001 LSB-first invece del CRC16-CCITT
    0x1021 MSB-first usato dal Mega -> ogni frame scartato per CRC error
    in entrambe le direzioni, link seriale di fatto morto. Allineato al
    crc16_ccitt del Mega.
    - Persistence (Mega) e ConfigManager (Hub): il CRC dei blob veniva
    calcolato includendo il campo crc16 stesso (valore vecchio) ed
    escludendo gli ultimi 2 byte di dati -> validazione sempre fallita,
    config/stats/credenziali resettate a ogni boot. Ora il CRC copre
    l'intera struct con il campo azzerato.
    - CAM: captureNow via MQTT non f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
    [ConfigManager.cpp, MainLogic.cpp, Persistence.cpp, SerialManager.cpp, main.cpp]
2026-06-18 fix: main.cpp fixed t0 defined
    [main.cpp]
2026-06-24 HUB device id hardcoded, not generated
2026-06-24 hardcode deviceId in CAM
2026-06-24 hardcode deviceId
2026-06-30 Add CRC utilities, command and sensor policies, and unit tests
    - Introduced crc_utils.h and crc_utils.cpp for CRC16-CCITT and CRC16-IBM calculations.
    - Added smartvase.pb.c for protobuf message definitions.
    - Created CommandPolicy.h and SensorPolicy.h for command and sensor logic.
    - Implemented unit tests for CRC calculations, command policies, sensor policies, and persistence logic.
    - Added scripts for syncing shared files and managing build processes.
    - Included example secrets.h for configuration management.
    - Established a .gitignore file for build artifacts and IDE configurations.
2026-07-01 Refactor and update documentation for SmartVase firmware
    - Translated comments and documentation from Italian to English in SystemStatus.h, Ultrasonic.cpp, Ultrasonic.h, and main.cpp for better accessibility.
    - Enhanced clarity of comments and descriptions throughout the codebase.
    - Added GrowLight functionality to main controller, including initialization and periodic updates based on ambient light conditions.
    - Updated README.md files in cloud functions and tests directories for improved clarity and consistency in English.
    - Improved test coverage in tests/host/ with additional unit tests for CRC utilities, command policies, sensor policies, and EEPROM persistence.
    - Removed unnecessary fo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
    [PINS - Sheet1.csv]
2026-07-03 fix device ids in SmartVase/SmartVase_data_structure.md
2026-07-03 Refactor ESP32-CAM monolithic main.cpp into clean SoC C++ modules
2026-07-03 Add Storage class for Firebase Storage operations
    - Implemented methods for downloading, uploading, and managing files in Firebase Storage.
    - Added support for OTA updates using firmware from Firebase Storage.
    - Included methods for retrieving metadata and listing objects in the storage bucket.
    - Enhanced error handling and asynchronous request management.
    - Introduced support for setting Arduino OTA storage.
    [Cli.cpp, Cli.h, MainLogic.cpp, Movement.cpp, Movement.h, Sensors.cpp, Sensors.h]
2026-07-06 fix: configmanager upload time set at 3600
    [ConfigManager.cpp]
2026-07-06 fix docs, comments, and prints
    [Cli.cpp, Communication.cpp, ConfigManager.cpp, Crc16.cpp, HubCli.cpp, MQTTManager.cpp, MainLogic.cpp]
2026-07-06 fix(vision): restore stable vision implementation from commit 1ff85e6
    [CameraDriver.cpp, CameraDriver.h, CloudService.cpp, CloudService.h, ConfigManager.cpp, ConfigManager.h, ConsoleCLI.cpp]
2026-07-07 fix drivers
2026-07-07 feat: Implement Hub to Mega time synchronization (proto v4.2)
    - Added epoch_s field to Heartbeat message for NTP synchronization.
    - Updated Mega's software clock to align with Hub's NTP time.
    - Introduced hubEpochPlausible function to validate received epoch.
    - Modified CLI to display last Hub sync time and epoch.
    - Enhanced Sensors class to handle epoch synchronization and maintain local time.
    - Updated documentation to reflect changes in RTC handling and time synchronization.
    - Bumped firmware versions for Hub (1.4.0) and Mega (5.4.0).
2026-07-07 fix: cam_console.py, port changed
    [cam_console.py]
2026-07-08 fix: correct UART connection notation and update team member role in README.md
2026-07-08 Update pitch video link in README
